timberwoof/miniature-potato/CircuitDiagram.jpg

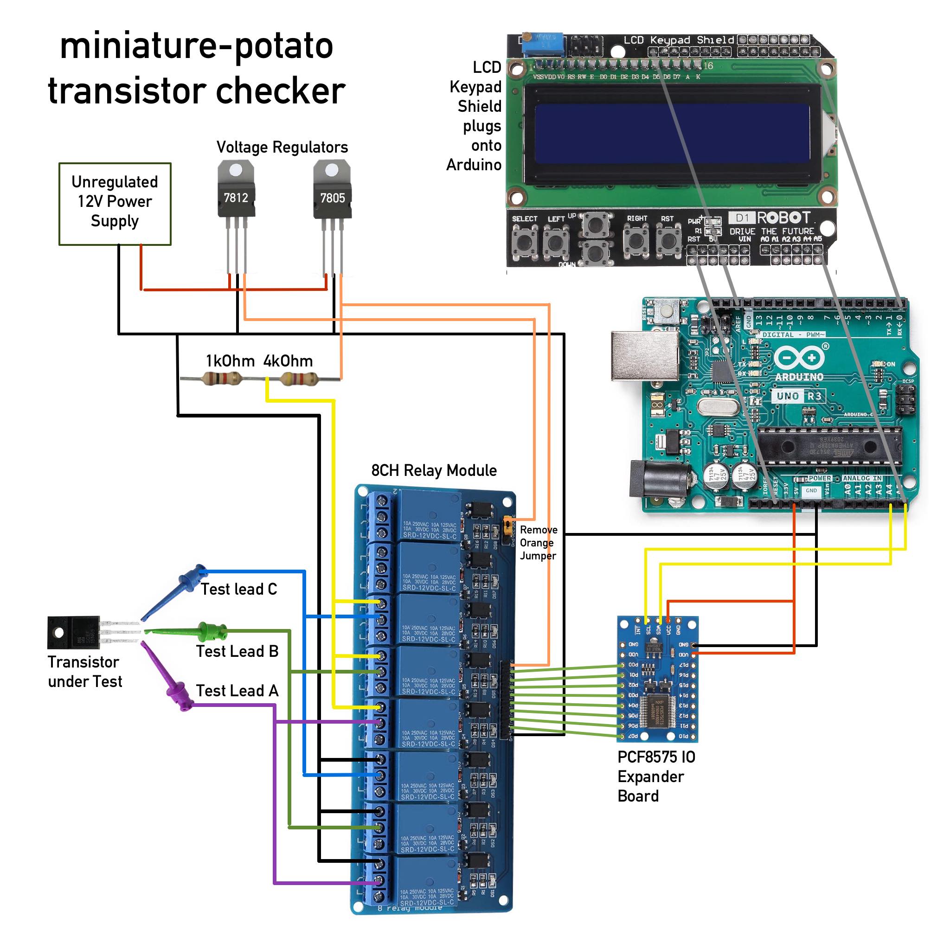
CircuitDiagram.jpg
