timberwoof/miniature-potato/(commit log)

2023-10-30 relays off
    Adds one function call to turn off all the relays after a test.
2023-11-01 added circuit diagram
